freetronics/PiLevenMini/PiLevenMini.pdf

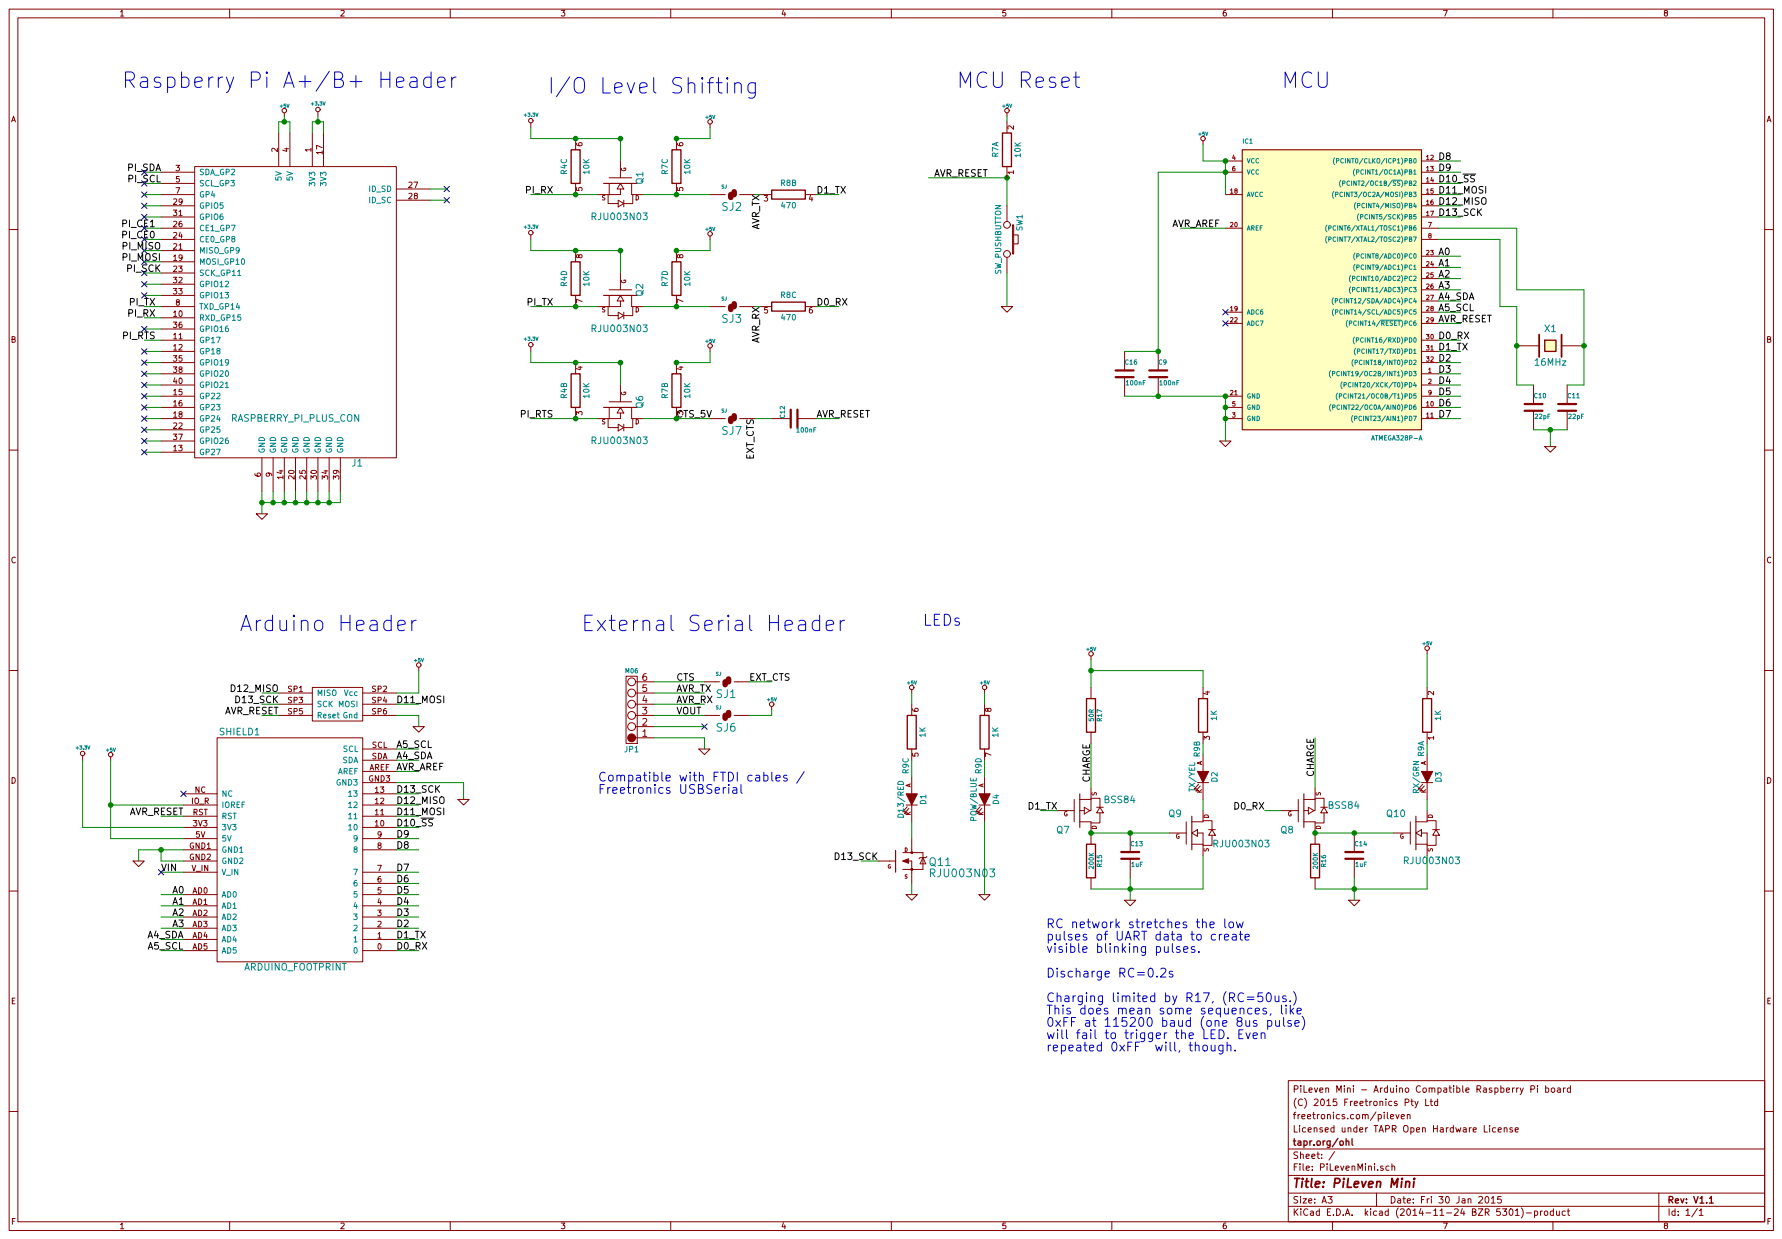
[picture p1: page 1]
