freetronics/PiLevenMini/PiLevenMini.sch

## KiCad design PiLevenMini.sch (2015-01-30)

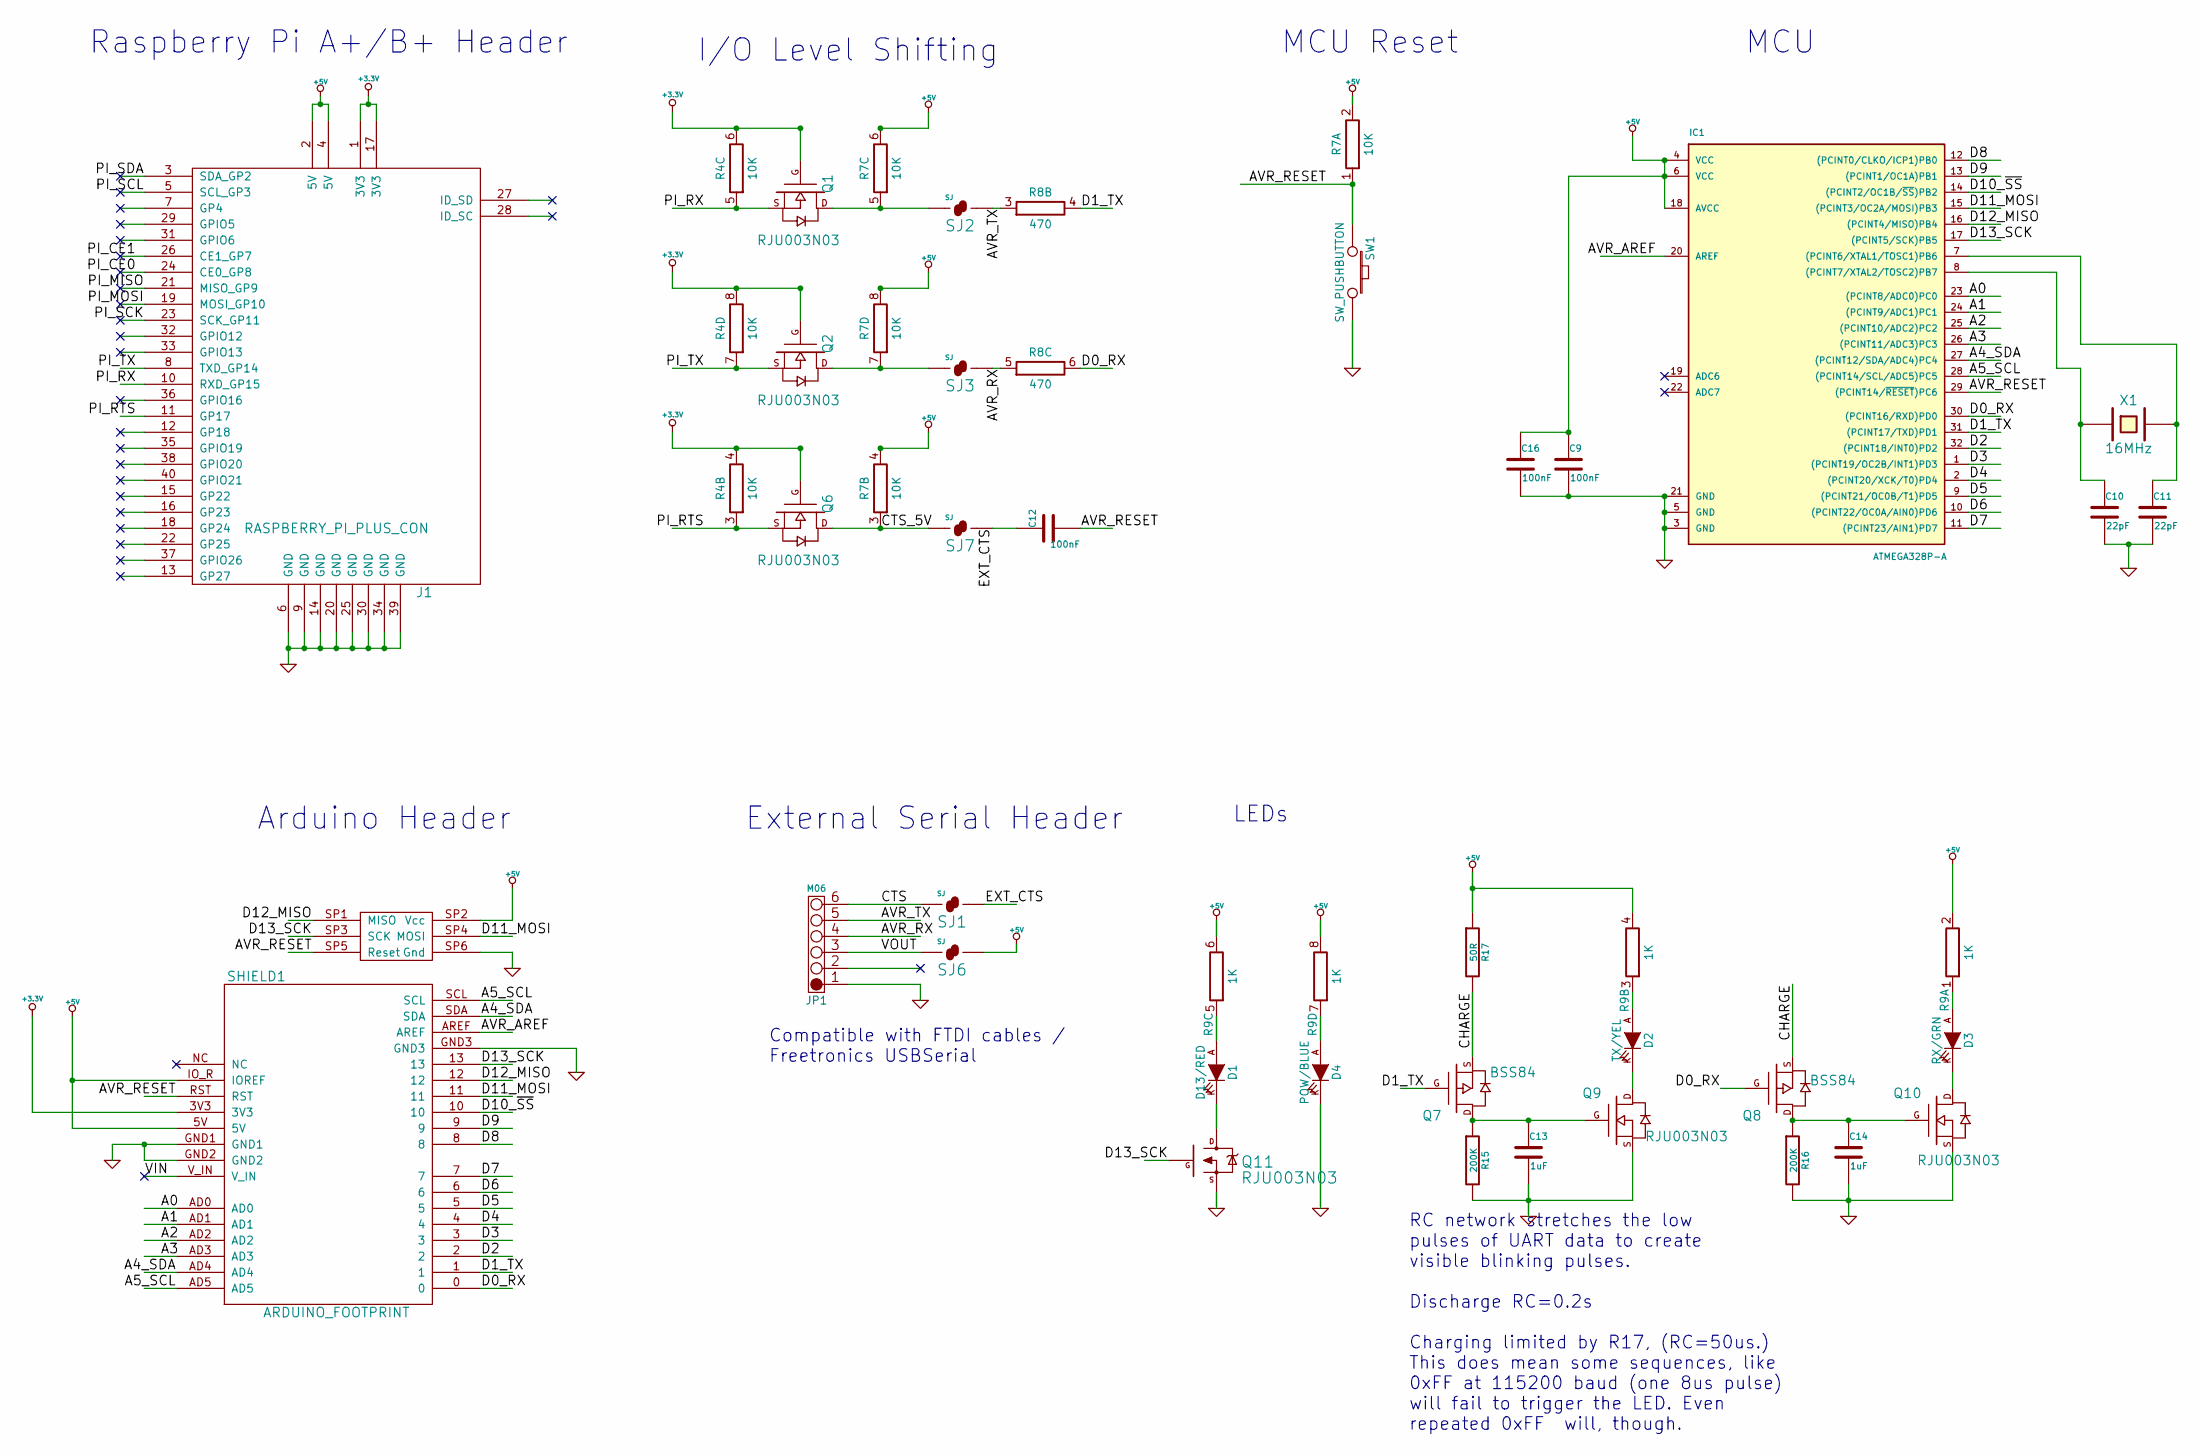
[picture p2: schematic PiLevenMini.sch]

Parts:
C9, C12, C16: 100nF; 0603_CAP
C10, C11: 22pF; 0603_CAP
C13, C14: 1uF; 0603_CAP
D1: D13/RED; LED-0603
D2: TX/YEL; LED-0603
D3: RX/GRN; LED-0603
D4: POW/BLUE; LED-0603
IC1: ATMEGA328P-A; QFP32_5mm_0.5mm
J1: RASPBERRY_PI_PLUS_CON; RASPBERRY_PI_HAT
JP1: M06; 1X06
Q1, Q2, Q6, Q9, Q10, Q11: RJU003N03; SOT323_FET
Q7, Q8: BSS84; SOT23_FET
R4, R7: 10K; RES_CAY16
R8: 470; RES_CAY16
R9: 1K; RES_CAY16
R15, R16: 200K; 0603
R17: 50R; 0603
SHIELD1: ARDUINO_FOOTPRINT; ARDUINO_SHIELD
SJ1, SJ2, SJ3, SJ6, SJ7: SJ; SJ_SHORTED
SW1: SW_PUSHBUTTON
X1: 16MHz; CRYSTAL_HC49_PTH

Connections:
+3.3V: J1.1 (3V3), J1.17 (3V3), Q1.G, Q2.G, Q6.G, R4.4 (8), R4.6 (8), R4.8, SHIELD1.3V3
+5V: C9.1, C16.1, IC1.4 (VCC), IC1.6 (VCC), IC1.18 (AVCC), J1.2 (5V), J1.4 (5V), R7.2 (8), R7.4 (8), R7.6 (8), R7.8, R9.2 (8), R9.4 (8), R9.6 (8), R9.8, R17.1, SHIELD1.5V, SHIELD1.IO_R (IOREF), SHIELD1.SP2 (Vcc), SJ6.2
A0: IC1.23 ((PCINT8/ADC0)PC0), SHIELD1.AD0
A1: IC1.24 ((PCINT9/ADC1)PC1), SHIELD1.AD1
A2: IC1.25 ((PCINT10/ADC2)PC2), SHIELD1.AD2
A3: IC1.26 ((PCINT11/ADC3)PC3), SHIELD1.AD3
A4_SDA: IC1.27 ((PCINT12/SDA/ADC4)PC4), SHIELD1.AD4, SHIELD1.SDA
A5_SCL: IC1.28 ((PCINT14/SCL/ADC5)PC5), SHIELD1.AD5, SHIELD1.SCL
AVR_AREF: IC1.20 (AREF), SHIELD1.AREF
AVR_RESET: C12.2, IC1.29 ((PCINT14/~RESET~)PC6), R7.1 (7), SHIELD1.RST, SHIELD1.SP5 (Reset), SW1.1
AVR_RX: JP1.4, R8.5 (7), SJ3.2
AVR_TX: JP1.5, R8.3 (7), SJ2.2
CHARGE: Q7.S, Q8.S, R17.2
CTS: JP1.6, SJ1.1
CTS_5V: Q6.D, R7.3 (7), SJ7.1
D0_RX: IC1.30 ((PCINT16/RXD)PD0), Q8.G, R8.6 (8), SHIELD1.0
D1_TX: IC1.31 ((PCINT17/TXD)PD1), Q7.G, R8.4 (8), SHIELD1.1
D2: IC1.32 ((PCINT18/INT0)PD2), SHIELD1.2
D3: IC1.1 ((PCINT19/OC2B/INT1)PD3), SHIELD1.3
D4: IC1.2 ((PCINT20/XCK/T0)PD4), SHIELD1.4
D5: IC1.9 ((PCINT21/OC0B/T1)PD5), SHIELD1.5
D6: IC1.10 ((PCINT22/OC0A/AIN0)PD6), SHIELD1.6
D7: IC1.11 ((PCINT23/AIN1)PD7), SHIELD1.7
D8: IC1.12 ((PCINT0/CLKO/ICP1)PB0), SHIELD1.8
D9: IC1.13 ((PCINT1/OC1A)PB1), SHIELD1.9
D10_~SS: IC1.14 ((PCINT2/OC1B/~SS~)PB2), SHIELD1.10
D11_MOSI: IC1.15 ((PCINT3/OC2A/MOSI)PB3), SHIELD1.11, SHIELD1.SP4 (MOSI)
D12_MISO: IC1.16 ((PCINT4/MISO)PB4), SHIELD1.12, SHIELD1.SP1 (MISO)
D13_SCK: IC1.17 ((PCINT5/SCK)PB5), Q11.G, SHIELD1.13, SHIELD1.SP3 (SCK)
EXT_CTS: C12.1, SJ1.2, SJ7.2
GND: C9.2, C10.2, C11.2, C13.2, C14.2, C16.2, D4.K, IC1.3 (GND), IC1.5 (GND), IC1.21 (GND), J1.6 (GND), J1.9 (GND), J1.14 (GND), J1.20 (GND), J1.25 (GND), J1.30 (GND), J1.34 (GND), J1.39 (GND), JP1.1, Q9.S, Q10.S, Q11.S, R15.2, R16.2, SHIELD1.GND1, SHIELD1.GND2, SHIELD1.GND3, SHIELD1.SP6 (Gnd), SW1.2
unnamed: C10.1, IC1.8 ((PCINT7/XTAL2/TOSC2)PB7), X1.1
unnamed: C11.1, IC1.7 ((PCINT6/XTAL1/TOSC1)PB6), X1.2
unnamed: C13.1, Q7.D, Q9.G, R15.1
unnamed: C14.1, Q8.D, Q10.G, R16.1
unnamed: D1.A, R9.5 (7)
unnamed: D1.K, Q11.D
unnamed: D2.A, R9.3 (7)
unnamed: D2.K, Q9.D
unnamed: D3.A, R9.1 (7)
unnamed: D3.K, Q10.D
unnamed: D4.A, R9.7
unnamed: Q1.D, R7.5 (7), SJ2.1
unnamed: Q2.D, R7.7, SJ3.1
PI_CE0: J1.24 (CE0_GP8)
PI_CE1: J1.26 (CE1_GP7)
PI_MISO: J1.21 (MISO_GP9)
PI_MOSI: J1.19 (MOSI_GP10)
PI_RTS: J1.11 (GP17), Q6.S, R4.3 (7)
PI_RX: J1.10 (RXD_GP15), Q1.S, R4.5 (7)
PI_SCK: J1.23 (SCK_GP11)
PI_SCL: J1.5 (SCL_GP3)
PI_SDA: J1.3 (SDA_GP2)
PI_TX: J1.8 (TXD_GP14), Q2.S, R4.7
VIN: SHIELD1.V_IN
VOUT: JP1.3, SJ6.1

Notes on the sheet:
I/O Level Shifting
MCU Reset
Raspberry Pi A+/B+ Header
Arduino Header
MCU
External Serial Header
LEDs
Compatible with FTDI cables / Freetronics USBSerial
RC network stretches the low pulses of UART data to create visible blinking pulses. Discharge RC=0.2s Charging limited by R17, (RC=50us.) This does mean some sequences, like 0xFF at 115200 baud (one 8us pulse) will fail to trigger the LED. Even repeated 0xFF will, though.
