freetronics/PiLevenMini/(commit log)

2014-11-20 First cut
    [PiLevenMini.kicad_pcb, PiLevenMini.sch]
2014-11-21 Refresh schematic, generate PDF
    [PiLevenMini.sch]
2014-11-21 Cleanup silk, place serial connector on-grid
    [PiLevenMini.kicad_pcb]
2015-01-23 V1.1: Fix V1.0 pin assignment problem, minor cleanup
    [PiLevenMini.kicad_pcb, PiLevenMini.sch]
2015-01-30 Bump PDF schematic
    [PiLevenMini.sch]
2015-01-30 Minor board cleanup for 1.1 release
    [PiLevenMini.kicad_pcb]
