freetronics/PiLevenMini/(notices)

Notices in the files:
PiLevenMini.sch:
Licensed under TAPR Open Hardware License
(C) 2015 Freetronics Pty Ltd
